JackkP/Semi-Truck-Backup-Camera/RPICAM_Adapter_PCB/KiCAD/References/Lichee Pi Zero Camera Pins.png

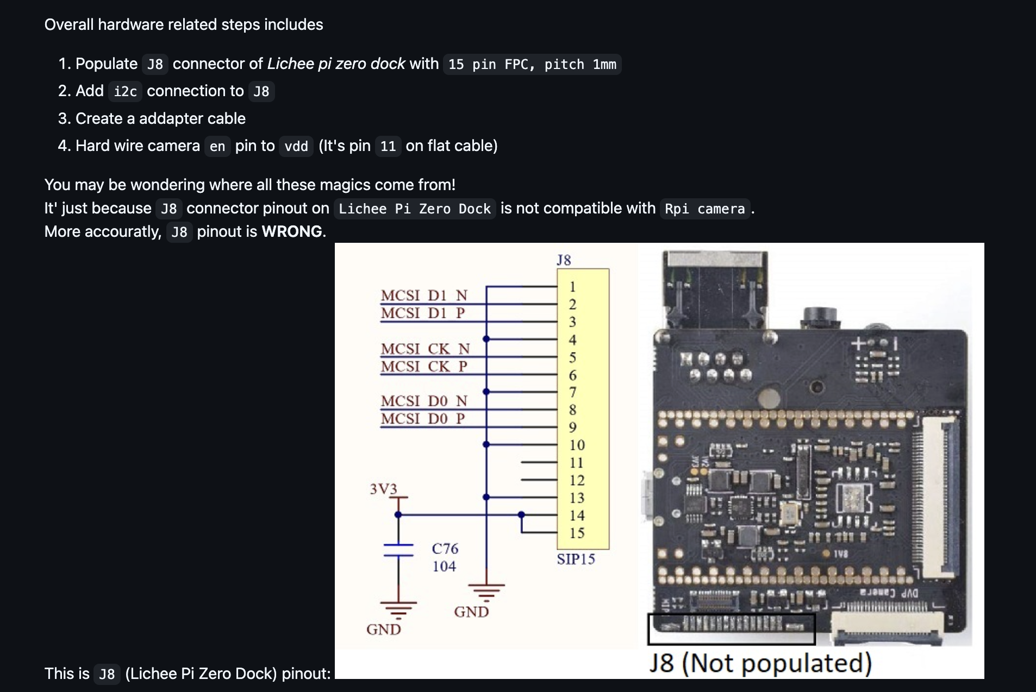
RPICAM_Adapter_PCB/KiCAD/References/Lichee Pi Zero Camera Pins.png
