JackkP/Semi-Truck-Backup-Camera/RPICAM_Adapter_PCB/KiCAD/References/Lichee Pi Zero Pin Mapping.png

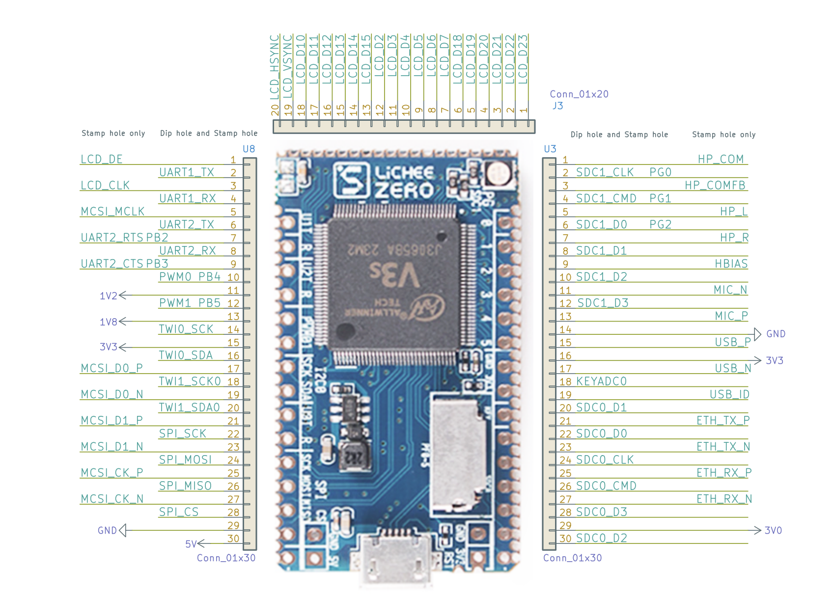
RPICAM_Adapter_PCB/KiCAD/References/Lichee Pi Zero Pin Mapping.png
