JackkP/Semi-Truck-Backup-Camera/README.md

# Semi-Truck-Backup-Camera
Repository for Team 25 Purdue ECE Senior Design Fall 2025 49022 Senior Design Project. This contains all of the code and schematics for the project. Course-related documentation is stored in google.
