JackkP/Semi-Truck-Backup-Camera/RPICAM_Adapter_PCB/KiCAD/References/RPI Camera Pinout.png

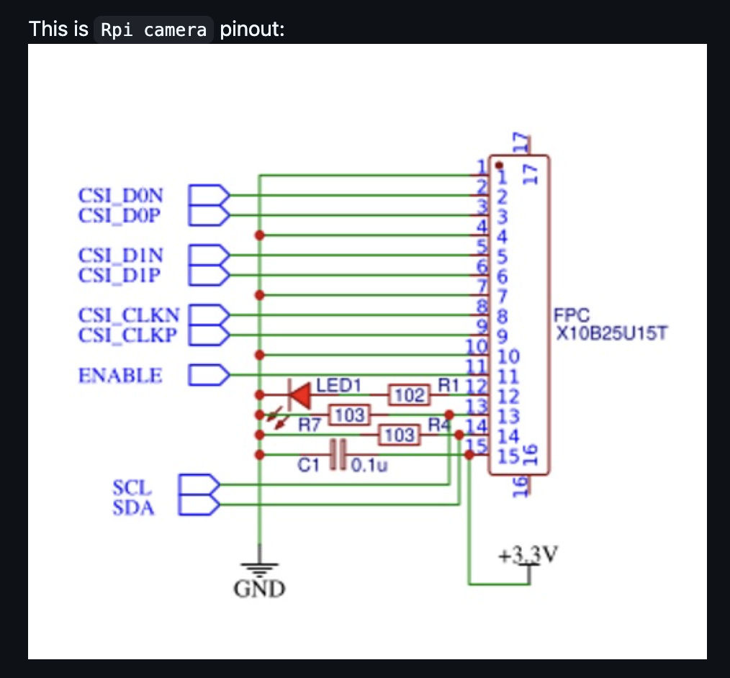
RPICAM_Adapter_PCB/KiCAD/References/RPI Camera Pinout.png
