JackkP/Semi-Truck-Backup-Camera/Camera_PCB/3D models/ECS-240-12-36-AGN-TR.step

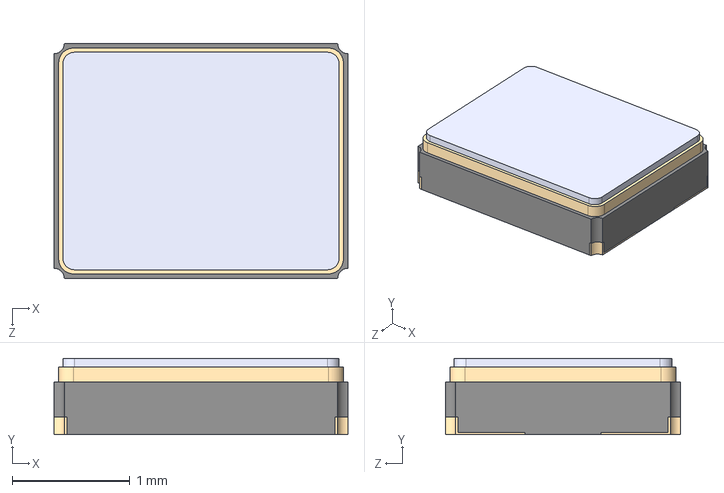
[picture p4: CAD file, 2025-11-12]
Camera_PCB/3D models/ECS-240-12-36-AGN-TR.step
2.50 x 0.65 x 2.00 mm
