JackkP/Semi-Truck-Backup-Camera/Camera_PCB/3D models/QFN48_P040_H085.stp

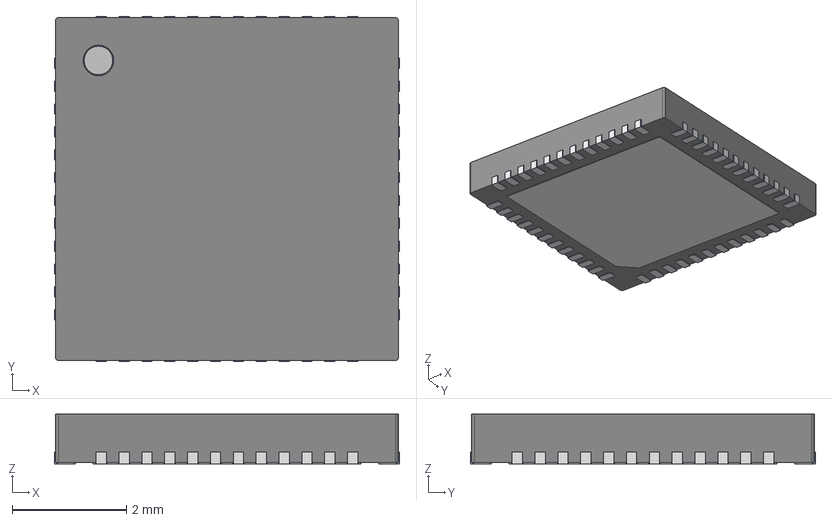
[picture p5: CAD file, 2025-11-12]
Camera_PCB/3D models/QFN48_P040_H085.stp
6.04 x 6.04 x 0.87 mm
QFN48P040_body
QFN48P040_pad
QFN48P040_pin x 48
