JackkP/Semi-Truck-Backup-Camera/Camera_PCB/3D models/B2B-PH-SM4-TB.step

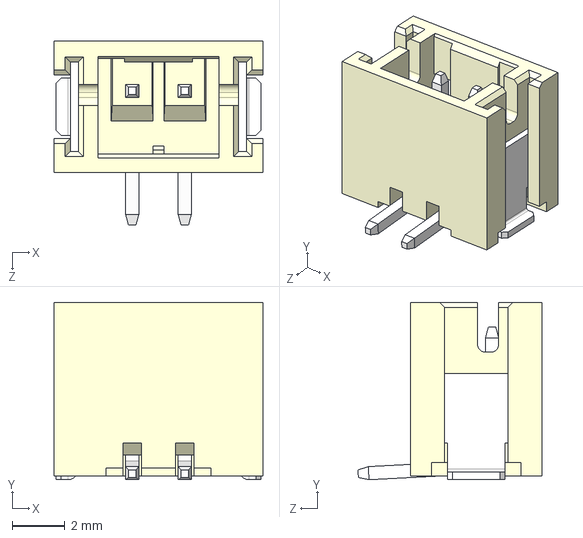
[picture p6: CAD file, 2025-11-12]
Camera_PCB/3D models/B2B-PH-SM4-TB.step
7.95 x 6.75 x 7.00 mm
