JackkP/Semi-Truck-Backup-Camera/Camera_PCB/3D models/ECS-.327-12.5-38-TR.STEP

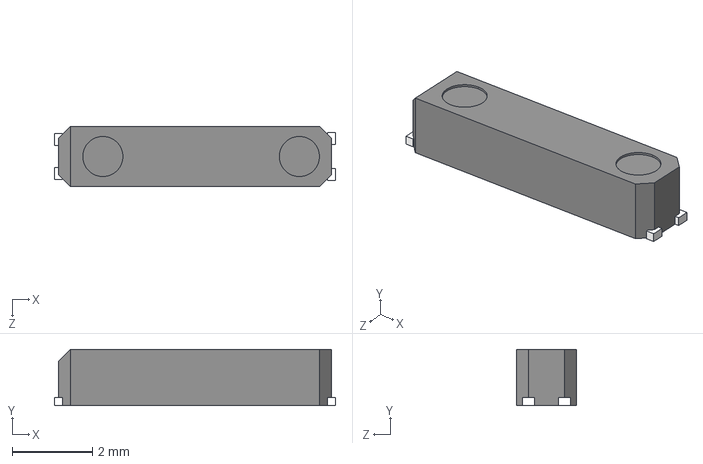
[picture p7: CAD file, 2025-11-12]
Camera_PCB/3D models/ECS-.327-12.5-38-TR.STEP
7.00 x 1.40 x 1.50 mm
