JackkP/Semi-Truck-Backup-Camera/Camera_PCB/3D models/USB1046-GF-0190-L-B-A.STEP

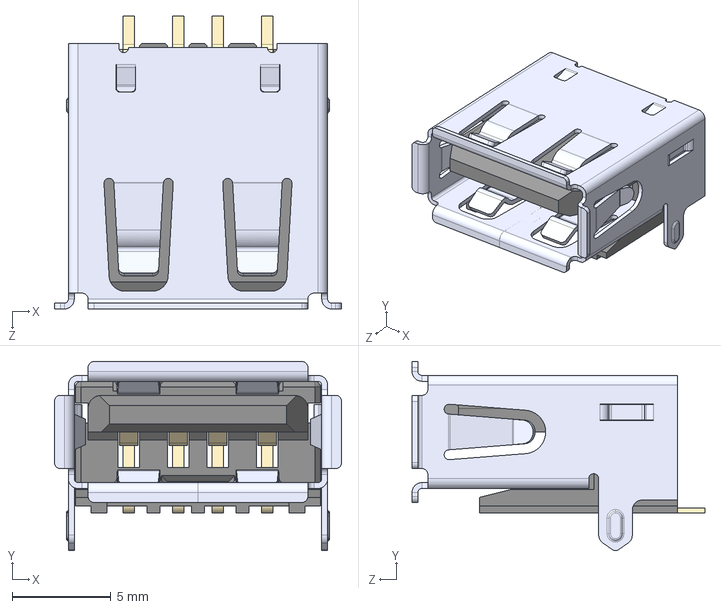
[picture p8: CAD file, 2025-11-12]
Camera_PCB/3D models/USB1046-GF-0190-L-B-A.STEP
14.5 x 9.55 x 14.8 mm
