JackkP/Semi-Truck-Backup-Camera/Camera_PCB/3D models/DFE201610E-1R0M=P2.STEP

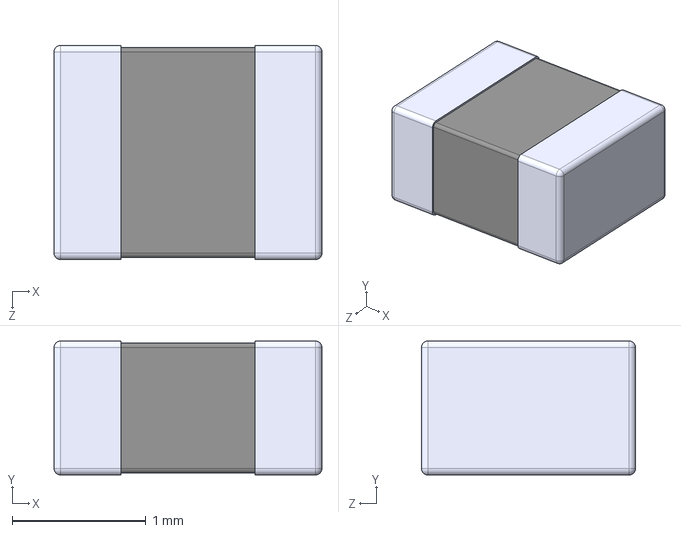
[picture p9: CAD file, 2025-11-12]
Camera_PCB/3D models/DFE201610E-1R0M=P2.STEP
2.00 x 1.00 x 1.60 mm
