JackkP/Semi-Truck-Backup-Camera/Camera_PCB/3D models/10067099-200LF.STEP

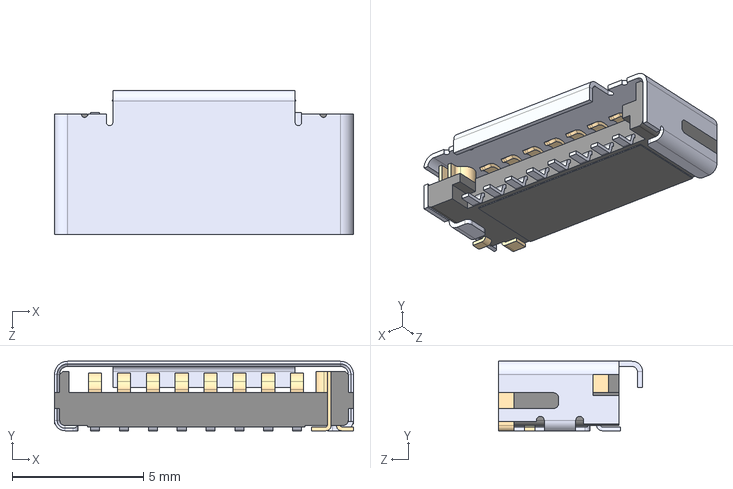
[picture p10: CAD file, 2025-11-12]
Camera_PCB/3D models/10067099-200LF.STEP
11.4 x 2.65 x 5.50 mm
