JackkP/Semi-Truck-Backup-Camera/Camera_PCB/3D models/TPS63020DSJT.step

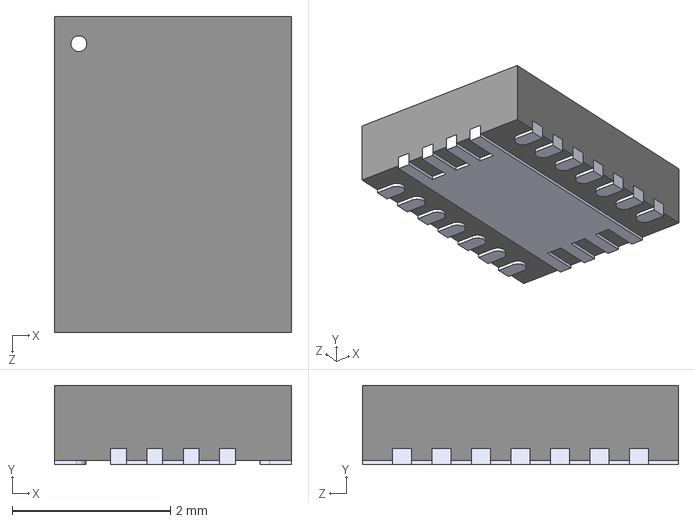
[picture p11: CAD file, 2025-11-12]
Camera_PCB/3D models/TPS63020DSJT.step
3.00 x 1.00 x 4.00 mm
