JackkP/Semi-Truck-Backup-Camera/Camera_PCB/CameraPCB.kicad_pcb

## KiCad design Camera_PCB/CameraPCB.kicad_pcb (2025-11-12)

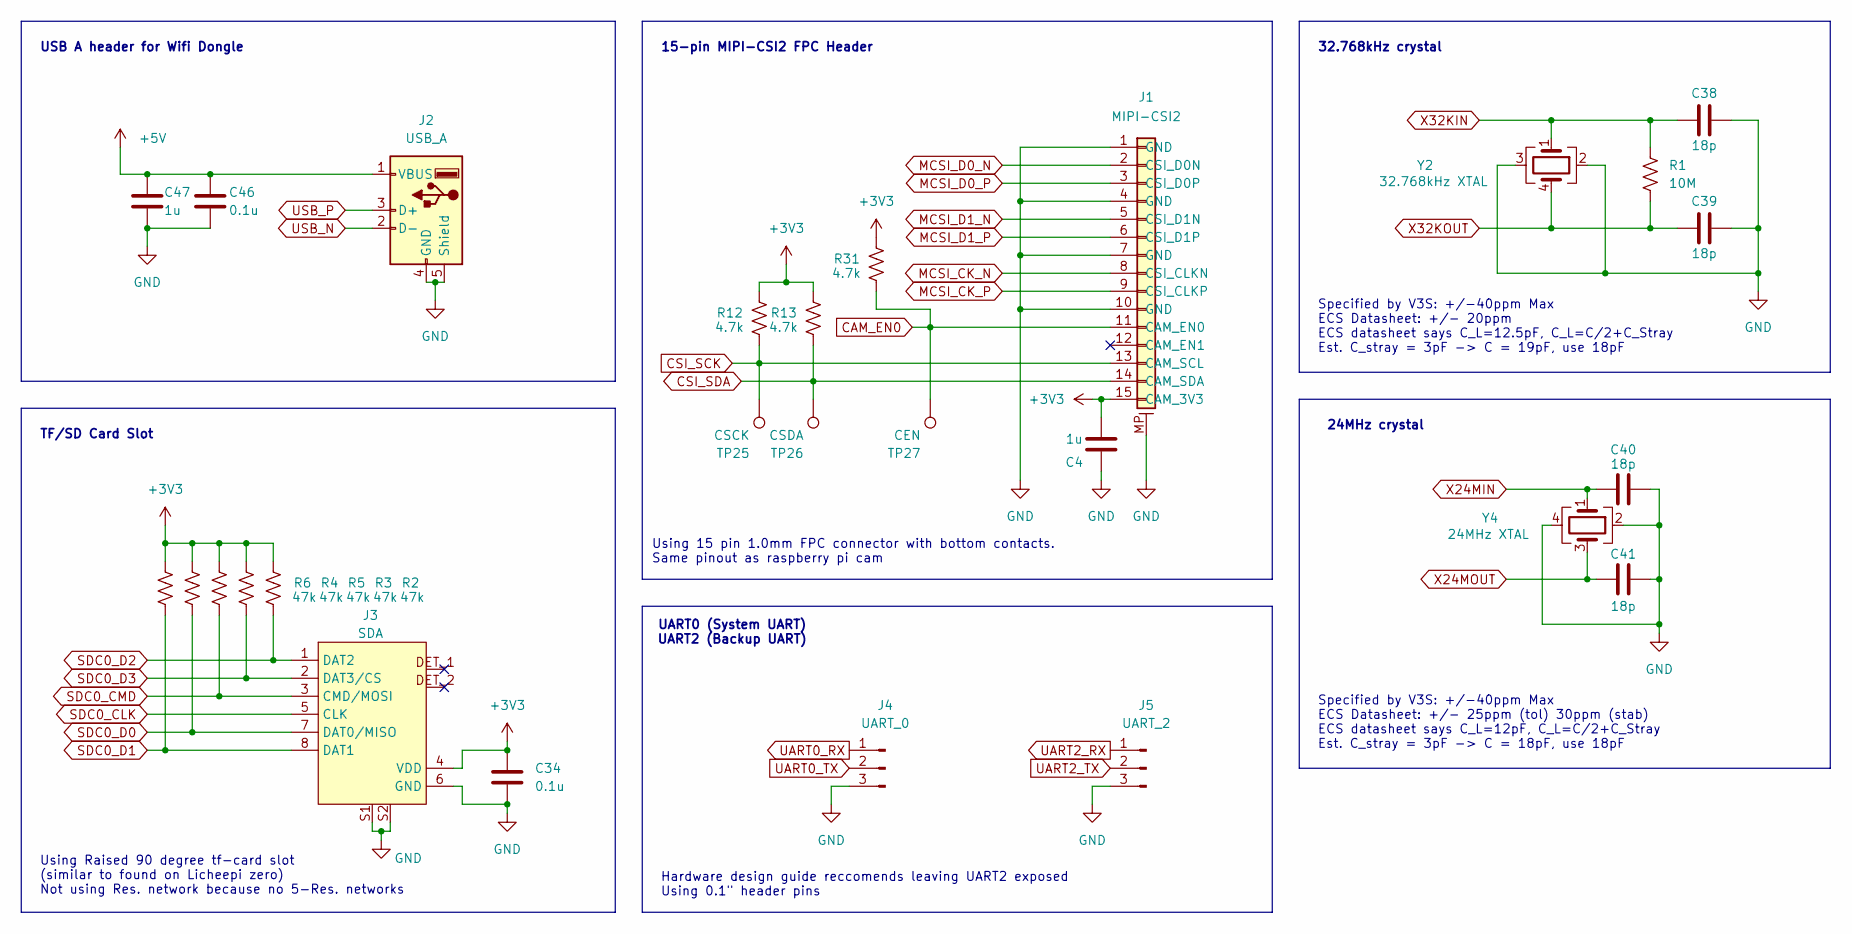
[picture p12: schematic CSI_USB_SD_OSC.kicad_sch, Wireless Backup Camera - Encoder]

Parts:
C4, C47: 1u; C_0603_1608Metric_Pad1.08x0.95mm_HandSolder
C34, C46: 0.1u; C_0603_1608Metric_Pad1.08x0.95mm_HandSolder
C38, C39, C40, C41: 18p; C_0603_1608Metric_Pad1.08x0.95mm_HandSolder
J1: MIPI-CSI2; TE_1-84952-5_1x15-1MP_P1.0mm_Horizontal
J2: USB_A; USB_A_Receptacle_GCT_USB1046
J3: SDA; AMPHENOL_10067099-200LF
J4: UART_0; PinHeader_1x03_P2.54mm_Vertical
J5: UART_2; PinHeader_1x03_P2.54mm_Vertical
R1: 10M; R_0603_1608Metric_Pad0.98x0.95mm_HandSolder
R2, R3, R4, R5, R6: 47k; R_0603_1608Metric_Pad0.98x0.95mm_HandSolder
R12, R13, R31: 4.7k; R_0603_1608Metric_Pad0.98x0.95mm_HandSolder
TP25: CSCK; TestPoint_Pad_D1.5mm
TP26: CSDA; TestPoint_Pad_D1.5mm
TP27: CEN; TestPoint_Pad_D1.5mm
Y2: 32.768kHz XTAL; XTAL_ECS-.327-12.5-38-TR
Y4: 24MHz XTAL; XTAL_ECS-240-12-36-AGN-TR

Connections:
+5V: C46.1, C47.1, J2.1 (VBUS); also elsewhere on the board
CAM_EN0: J1.11 (CAM_EN0), R31.2, TP27.1; also elsewhere on the board
CSI_SCK: J1.13 (CAM_SCL), R12.2, TP25.1; also elsewhere on the board
CSI_SDA: J1.14 (CAM_SDA), R13.2, TP26.1; also elsewhere on the board
GND: C4.2, C34.2, C38.2, C39.2, C40.2, C41.1, C46.2, C47.2, J1.1 (GND), J1.4 (GND), J1.7 (GND), J1.10 (GND), J1.MP, J2.4 (GND), J2.5 (Shield), J3.6 (GND), J3.S1, J3.S2, J4.3, J5.3, Y2.2, Y2.3, Y4.2, Y4.4; also elsewhere on the board
HPVCC: C4.1, C34.1, J1.15 (CAM_3V3), J3.4 (VDD), R2.1, R3.1, R4.1, R5.1, R6.1, R12.1, R13.1, R31.1; also elsewhere on the board
MCSI_CK_N: J1.8 (CSI_CLKN); also elsewhere on the board
MCSI_CK_P: J1.9 (CSI_CLKP); also elsewhere on the board
MCSI_D0_N: J1.2 (CSI_D0N); also elsewhere on the board
MCSI_D0_P: J1.3 (CSI_D0P); also elsewhere on the board
MCSI_D1_N: J1.5 (CSI_D1N); also elsewhere on the board
MCSI_D1_P: J1.6 (CSI_D1P); also elsewhere on the board
SDC0_CLK: J3.5 (CLK); also elsewhere on the board
SDC0_CMD: J3.3 (CMD/MOSI), R5.2; also elsewhere on the board
SDC0_D0: J3.7 (DAT0/MISO), R4.2; also elsewhere on the board
SDC0_D1: J3.8 (DAT1), R6.2; also elsewhere on the board
SDC0_D2: J3.1 (DAT2), R2.2; also elsewhere on the board
SDC0_D3: J3.2 (DAT3/CS), R3.2; also elsewhere on the board
UART0_RX: J4.1; also elsewhere on the board
UART0_TX: J4.2; also elsewhere on the board
UART2_RX: J5.1; also elsewhere on the board
UART2_TX: J5.2; also elsewhere on the board
USB_N: J2.2 (D-); also elsewhere on the board
USB_P: J2.3 (D+); also elsewhere on the board
X24MIN: C40.1, Y4.1; also elsewhere on the board
X24MOUT: C41.2, Y4.3; also elsewhere on the board
X32KIN: C38.1, R1.1, Y2.1; also elsewhere on the board
X32KOUT: C39.1, R1.2, Y2.4; also elsewhere on the board

Notes on the sheet:
TF/SD Card Slot
Hardware design guide reccomends leaving UART2 exposed Using 0.1" header pins
15-pin MIPI-CSI2 FPC Header
UART0 (System UART) UART2 (Backup UART)
Specified by V3S: +/-40ppm Max ECS Datasheet: +/- 25ppm (tol) 30ppm (stab) ECS datasheet says C_L=12pF, C_L=C/2+C_Stray Est. C_stray = 3pF -> C = 18pF, use 18pF
Specified by V3S: +/-40ppm Max ECS Datasheet: +/- 20ppm ECS datasheet says C_L=12.5pF, C_L=C/2+C_Stray Est. C_stray = 3pF -> C = 19pF, use 18pF
32.768kHz crystal
Using 15 pin 1.0mm FPC connector with bottom contacts. Same pinout as raspberry pi cam
24MHz crystal
USB A header for Wifi Dongle
Using Raised 90 degree tf-card slot (similar to found on Licheepi zero) Not using Res. network because no 5-Res. networks

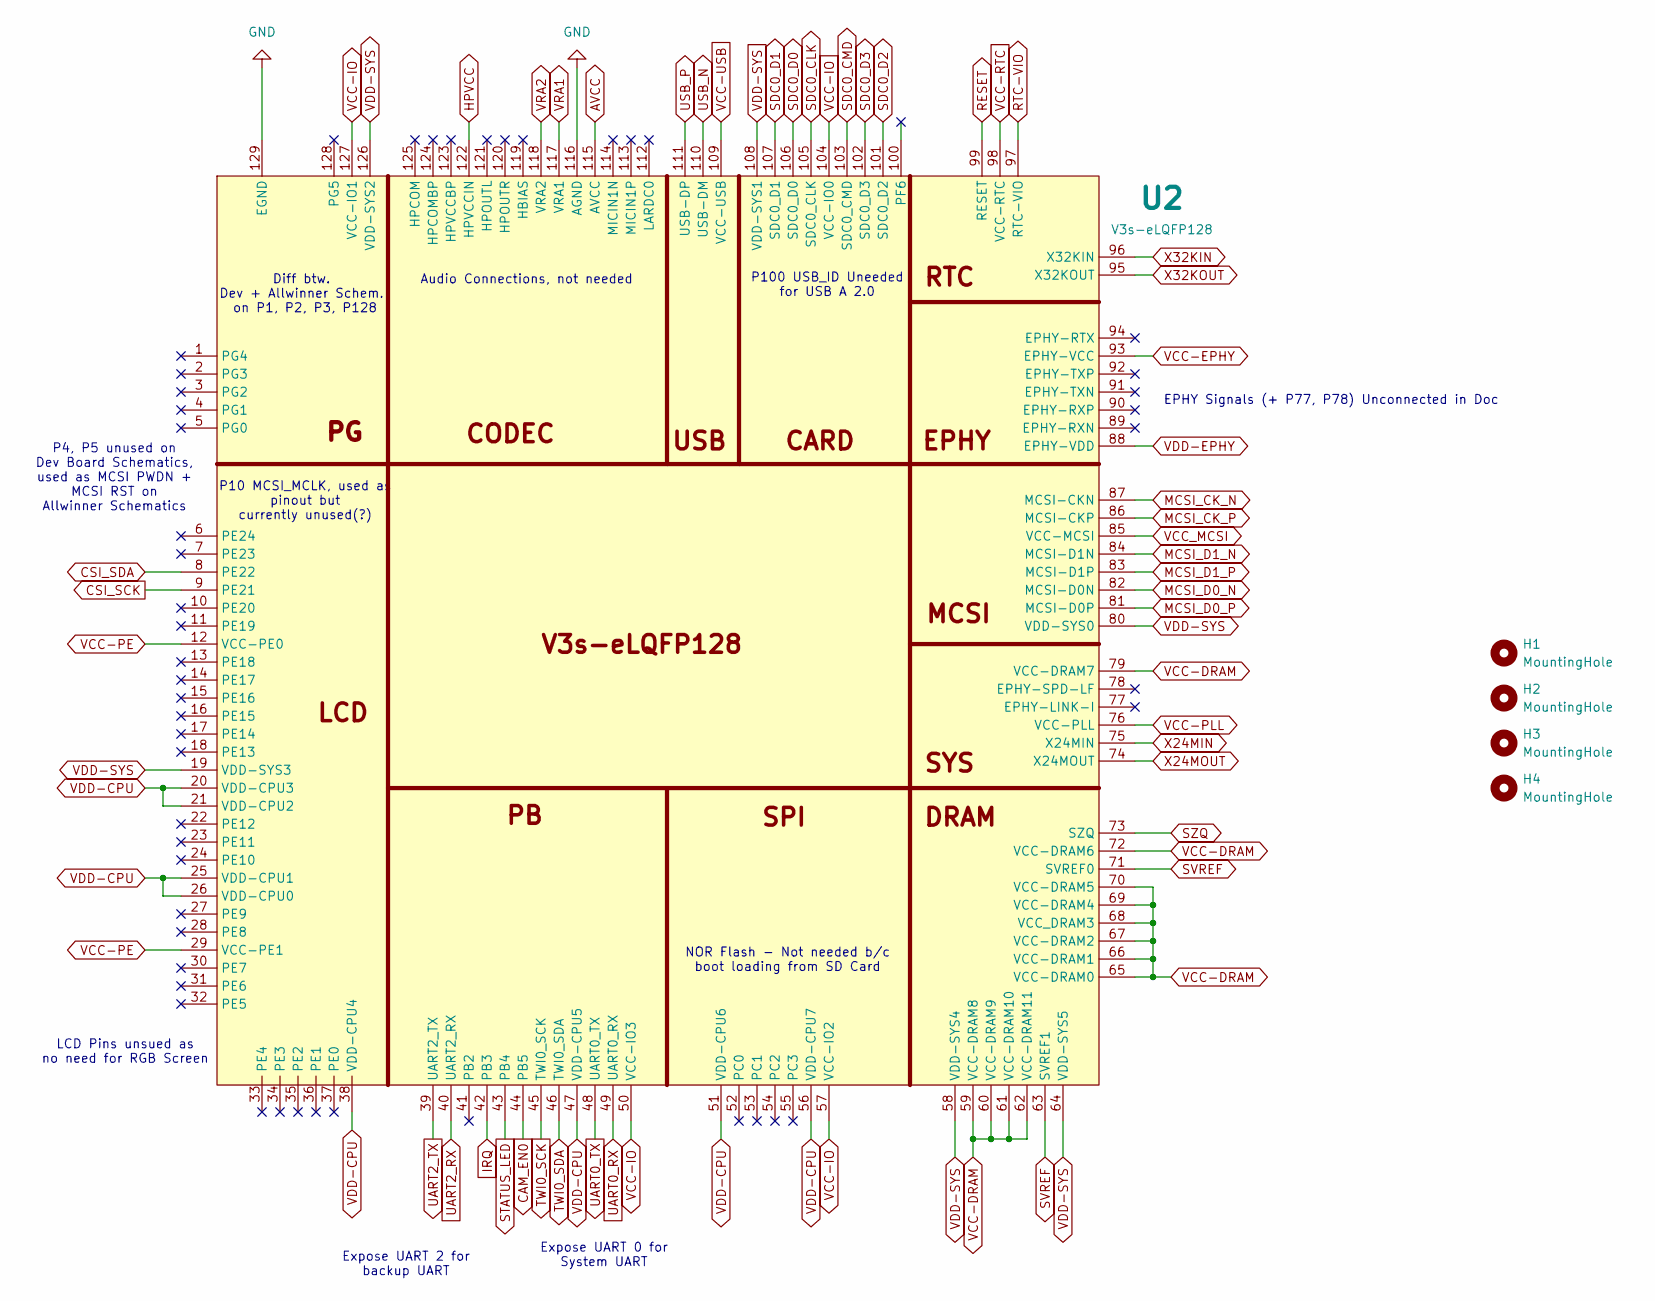
[picture p13: schematic V3s.kicad_sch]

Parts:
H1, H2, H3, H4: MountingHole; MountingHole_2.2mm_M2
U2: V3s-eLQFP128; LQFP-128_14x14mm_P0.4mm

Connections:
AVCC: U2.76 (VCC-PLL), U2.115 (AVCC); also elsewhere on the board
CAM_EN0: U2.44 (PB5); also elsewhere on the board
CSI_SCK: U2.9 (PE21); also elsewhere on the board
CSI_SDA: U2.8 (PE22); also elsewhere on the board
GND: U2.116 (AGND), U2.129 (EGND); also elsewhere on the board
HPVCC: U2.12 (VCC-PE0), U2.29 (VCC-PE1), U2.50 (VCC-IO3), U2.57 (VCC-IO2), U2.85 (VCC-MCSI), U2.93 (EPHY-VCC), U2.104 (VCC-IO0), U2.109 (VCC-USB), U2.122 (HPVCCIN), U2.127 (VCC-IO1); also elsewhere on the board
IRQ: U2.42 (PB3); also elsewhere on the board
MCSI_CK_N: U2.87 (MCSI-CKN); also elsewhere on the board
MCSI_CK_P: U2.86 (MCSI-CKP); also elsewhere on the board
MCSI_D0_N: U2.82 (MCSI-D0N); also elsewhere on the board
MCSI_D0_P: U2.81 (MCSI-D0P); also elsewhere on the board
MCSI_D1_N: U2.84 (MCSI-D1N); also elsewhere on the board
MCSI_D1_P: U2.83 (MCSI-D1P); also elsewhere on the board
RESET: U2.99 (RESET); also elsewhere on the board
RTC-VIO: U2.97 (RTC-VIO); also elsewhere on the board
SDC0_CLK: U2.105 (SDC0_CLK); also elsewhere on the board
SDC0_CMD: U2.103 (SDC0_CMD); also elsewhere on the board
SDC0_D0: U2.106 (SDC0_D0); also elsewhere on the board
SDC0_D1: U2.107 (SDC0_D1); also elsewhere on the board
SDC0_D2: U2.101 (SDC0_D2); also elsewhere on the board
SDC0_D3: U2.102 (SDC0_D3); also elsewhere on the board
STATUS_LED: U2.43 (PB4); also elsewhere on the board
SVREF: U2.63 (SVREF1), U2.71 (SVREF0); also elsewhere on the board
SZQ: U2.73 (SZQ); also elsewhere on the board
TWI0_SCK: U2.45 (TWI0_SCK); also elsewhere on the board
TWI0_SDA: U2.46 (TWI0_SDA); also elsewhere on the board
UART0_RX: U2.49 (UART0_RX); also elsewhere on the board
UART0_TX: U2.48 (UART0_TX); also elsewhere on the board
UART2_RX: U2.40 (UART2_RX); also elsewhere on the board
UART2_TX: U2.39 (UART2_TX); also elsewhere on the board
USB_N: U2.110 (USB-DM); also elsewhere on the board
USB_P: U2.111 (USB-DP); also elsewhere on the board
VCC-DRAM: U2.59 (VCC-DRAM8), U2.60 (VCC-DRAM9), U2.61 (VCC-DRAM10), U2.62 (VCC-DRAM11), U2.65 (VCC-DRAM0), U2.66 (VCC-DRAM1), U2.67 (VCC-DRAM2), U2.68 (VCC_DRAM3), U2.69 (VCC-DRAM4), U2.70 (VCC-DRAM5), U2.72 (VCC-DRAM6), U2.79 (VCC-DRAM7); also elsewhere on the board
VCC-RTC: U2.98 (VCC-RTC); also elsewhere on the board
VDD-CPU: U2.19 (VDD-SYS3), U2.20 (VDD-CPU3), U2.21 (VDD-CPU2), U2.25 (VDD-CPU1), U2.26 (VDD-CPU0), U2.38 (VDD-CPU4), U2.47 (VDD-CPU5), U2.51 (VDD-CPU6), U2.56 (VDD-CPU7), U2.58 (VDD-SYS4), U2.64 (VDD-SYS5), U2.80 (VDD-SYS0), U2.88 (EPHY-VDD), U2.108 (VDD-SYS1), U2.126 (VDD-SYS2); also elsewhere on the board
VRA1: U2.117 (VRA1); also elsewhere on the board
VRA2: U2.118 (VRA2); also elsewhere on the board
X24MIN: U2.75 (X24MIN); also elsewhere on the board
X24MOUT: U2.74 (X24MOUT); also elsewhere on the board
X32KIN: U2.96 (X32KIN); also elsewhere on the board
X32KOUT: U2.95 (X32KOUT); also elsewhere on the board

Notes on the sheet:
P10 MCSI_MCLK, used as pinout but currently unused(?)
EPHY Signals (+ P77, P78) Unconnected in Doc
Audio Connections, not needed
NOR Flash - Not needed b/c boot loading from SD Card
P4, P5 unused on Dev Board Schematics, used as MCSI PWDN + MCSI RST on Allwinner Schematics
P100 USB_ID Uneeded for USB A 2.0
Expose UART 2 for backup UART
LCD Pins unsued as no need for RGB Screen
Expose UART 0 for System UART
Diff btw. Dev + Allwinner Schem. on P1, P2, P3, P128

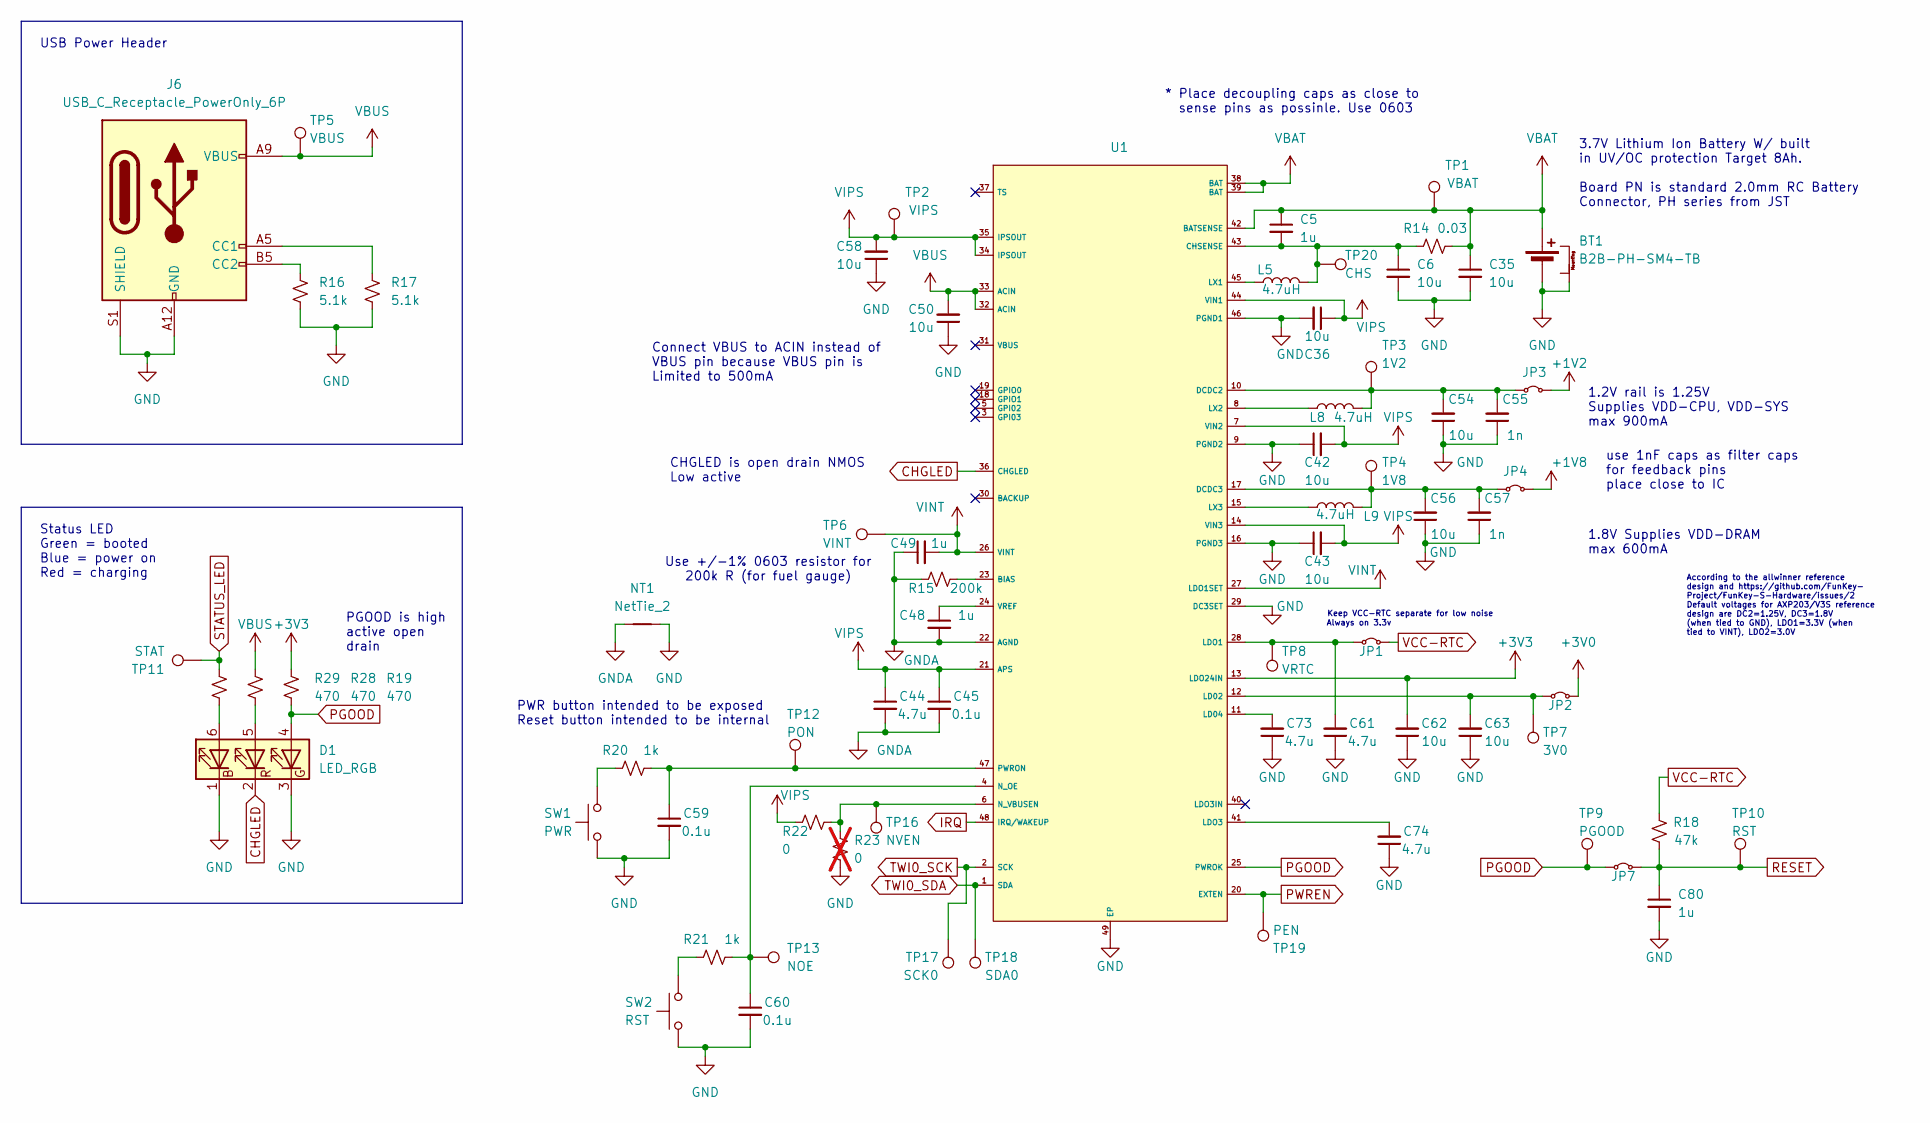
[picture p14: schematic AXP203.kicad_sch]

Parts:
BT1: B2B-PH-SM4-TB; JST_PH_B2B-PH-SM4-TB_1x02-1MP_P2.00mm_Vertical
C5, C48, C49, C80: 1u; C_0603_1608Metric_Pad1.08x0.95mm_HandSolder
C6, C35, C36, C42, C43, C50, C54, C56, C58, C62, C63: 10u; C_0805_2012Metric_Pad1.18x1.45mm_HandSolder
C44, C61, C73, C74: 4.7u; C_0805_2012Metric_Pad1.18x1.45mm_HandSolder
C45, C59, C60: 0.1u; C_0603_1608Metric_Pad1.08x0.95mm_HandSolder
C55, C57: 1n; C_0603_1608Metric_Pad1.08x0.95mm_HandSolder
D1: LED_RGB; RGB_LED IN-S66TFT5R5G5B
J6: USB_C_Receptacle_PowerOnly_6P; USB_C_Receptacle_GCT_USB4125-xx-x_6P_TopMnt_Horizontal
JP1, JP2, JP3, JP4, JP7: SolderJumper-2_P1.3mm_Open_Pad1.0x1.5mm
L5, L8, L9: 4.7uH; L_TDK_SLF6045
NT1: NetTie_2; NetTie-2_SMD_Pad0.5mm
R14: 0.03; R_1206_3216Metric
R15: 200k; R_0603_1608Metric_Pad0.98x0.95mm_HandSolder
R16, R17: 5.1k; R_0603_1608Metric_Pad0.98x0.95mm_HandSolder
R18: 47k; R_0603_1608Metric_Pad0.98x0.95mm_HandSolder
R19, R28, R29: 470; R_0603_1608Metric_Pad0.98x0.95mm_HandSolder
R20, R21: 1k; R_0603_1608Metric_Pad0.98x0.95mm_HandSolder
R22: 0; R_0603_1608Metric_Pad0.98x0.95mm_HandSolder
R23: 0; R_0603_1608Metric_Pad0.98x0.95mm_HandSolder; not fitted
SW1: PWR; SW_SPST_PTS647_Sx38
SW2: RST; SW_SPST_PTS647_Sx38
TP1: VBAT; TestPoint_Pad_D1.5mm
TP2: VIPS; TestPoint_Pad_D1.5mm
TP3: 1V2; TestPoint_Pad_D1.5mm
TP4: 1V8; TestPoint_Pad_D1.5mm
TP5: VBUS; TestPoint_Pad_D1.5mm
TP6: VINT; TestPoint_Pad_D1.5mm
TP7: 3V0; TestPoint_Pad_D1.5mm
TP8: VRTC; TestPoint_Pad_D1.5mm
TP9: PGOOD; TestPoint_Pad_D1.5mm
TP10: RST; TestPoint_Pad_D1.5mm
TP11: STAT; TestPoint_Pad_D1.5mm
TP12: PON; TestPoint_Pad_D1.5mm
TP13: NOE; TestPoint_Pad_D1.5mm
TP16: NVEN; TestPoint_Pad_D1.5mm
TP17: SCK0; TestPoint_Pad_D1.5mm
TP18: SDA0; TestPoint_Pad_D1.5mm
TP19: PEN; TestPoint_Pad_D1.5mm
TP20: CHS; TestPoint_Pad_D1.5mm
U1: AXP203; QFN-48-1EP_6x6mm_P0.4mm_EP4.2x4.2mm

Connections:
AVCC: JP2.2 (B); also elsewhere on the board
CHGLED: D1.2 (GK), U1.36 (CHGLED)
GND: BT1.2 (-), BT1.MP, C6.2, C35.2, C36.2, C42.1, C43.1, C50.1, C54.1, C55.1, C56.1, C57.1, C58.1, C59.2, C60.2, C61.1, C62.1, C63.1, C73.1, C74.1, C80.2, D1.1 (RK), D1.3 (BK), J6.A12 (GND), J6.B12 (GND), J6.S1 (SHIELD), NT1.2, R16.2, R17.2, R23.1, SW1.1, SW2.1, U1.9 (PGND2), U1.16 (PGND3), U1.29 (DC3SET), U1.46 (PGND1), U1.49 (EP); also elsewhere on the board
GNDA: C44.2, C45.2, C48.2, C49.1, NT1.1, R15.1, U1.22 (AGND)
HPVCC: C62.2, R19.1, U1.13 (LDO24IN); also elsewhere on the board
IRQ: U1.48 (IRQ/WAKEUP); also elsewhere on the board
unnamed: D1.5 (GA), R28.2
unnamed: D1.6 (RA), R29.2
unnamed: J6.A5 (CC1), R17.1
unnamed: J6.B5 (CC2), R16.1
unnamed: C61.2, JP1.1 (A), TP8.1, U1.28 (LDO1)
unnamed: C63.2, JP2.1 (A), TP7.1, U1.12 (LD02)
unnamed: C54.2, C55.2, JP3.1 (A), L8.2, TP3.1, U1.10 (DCDC2)
unnamed: C56.2, C57.2, JP4.1 (A), L9.2, TP4.1, U1.17 (DCDC3)
unnamed: R20.1, SW1.2
unnamed: R21.1, SW2.2
unnamed: R15.2, U1.23 (BIAS)
unnamed: C5.2, C6.1, L5.2, R14.1, TP20.1, U1.43 (CHSENSE)
unnamed: C73.2, U1.11 (LD04)
unnamed: C74.2, U1.41 (LDO3)
unnamed: L5.1, U1.45 (LX1)
unnamed: L8.1, U1.8 (LX2)
unnamed: L9.1, U1.15 (LX3)
unnamed: C60.1, R21.2, TP13.1, U1.4 (N_OE)
unnamed: R22.2, R23.2, TP16.1, U1.6 (N_VBUSEN)
unnamed: C59.1, R20.2, TP12.1, U1.47 (PWRON)
unnamed: C48.1, U1.24 (VREF)
PGOOD: D1.4 (BA), JP7.1 (A), R19.2, TP9.1, U1.25 (PWROK); also elsewhere on the board
PWREN: TP19.1, U1.20 (EXTEN); also elsewhere on the board
RESET: C80.1, JP7.2 (B), R18.2, TP10.1; also elsewhere on the board
STATUS_LED: R29.1, TP11.1; also elsewhere on the board
TWI0_SCK: TP17.1, U1.2 (SCK); also elsewhere on the board
TWI0_SDA: TP18.1, U1.1 (SDA); also elsewhere on the board
VBAT: BT1.1 (+), C5.1, C35.1, R14.2, TP1.1, U1.38 (BAT), U1.39 (BAT), U1.42 (BATSENSE); also elsewhere on the board
VBUS: C50.2, J6.A9 (VBUS), J6.B9 (VBUS), R28.1, TP5.1, U1.32 (ACIN), U1.33 (ACIN)
VCC-DRAM: JP4.2 (B); also elsewhere on the board
VCC-RTC: JP1.2 (B), R18.1; also elsewhere on the board
VDD-CPU: JP3.2 (B); also elsewhere on the board
VINT: C49.2, TP6.1, U1.26 (VINT), U1.27 (LDO1SET)
VIPS: C36.1, C42.2, C43.2, C44.1, C45.1, C58.2, R22.1, TP2.1, U1.7 (VIN2), U1.14 (VIN3), U1.21 (APS), U1.34 (IPSOUT), U1.35 (IPSOUT), U1.44 (VIN1); also elsewhere on the board

Notes on the sheet:
1.2V rail is 1.25V Supplies VDD-CPU, VDD-SYS max 900mA
PWR button intended to be exposed Reset button intended to be internal
PGOOD is high active open drain
Connect VBUS to ACIN instead of VBUS pin because VBUS pin is Limited to 500mA
USB Power Header
CHGLED is open drain NMOS Low active
use 1nF caps as filter caps for feedback pins place close to IC
According to the allwinner reference design and https://github.com/FunKey- Project/FunKey-S-Hardware/issues/2 Default voltages for AXP203/V3S reference design are DC2=1.25V, DC3=1.8V (when tied to GND), LDO1=3.3V (when tied to VINT), LDO2=3.0V
3.7V Lithium Ion Battery W/ built in UV/OC protection Target 8Ah. Board PN is standard 2.0mm RC Battery Connector, PH series from JST
Always on 3.3v
Keep VCC-RTC separate for low noise
Use +/-1% 0603 resistor for 200k R (for fuel gauge)
Status LED Green = booted Blue = power on Red = charging
* Place decoupling caps as close to sense pins as possinle. Use 0603
1.8V Supplies VDD-DRAM max 600mA

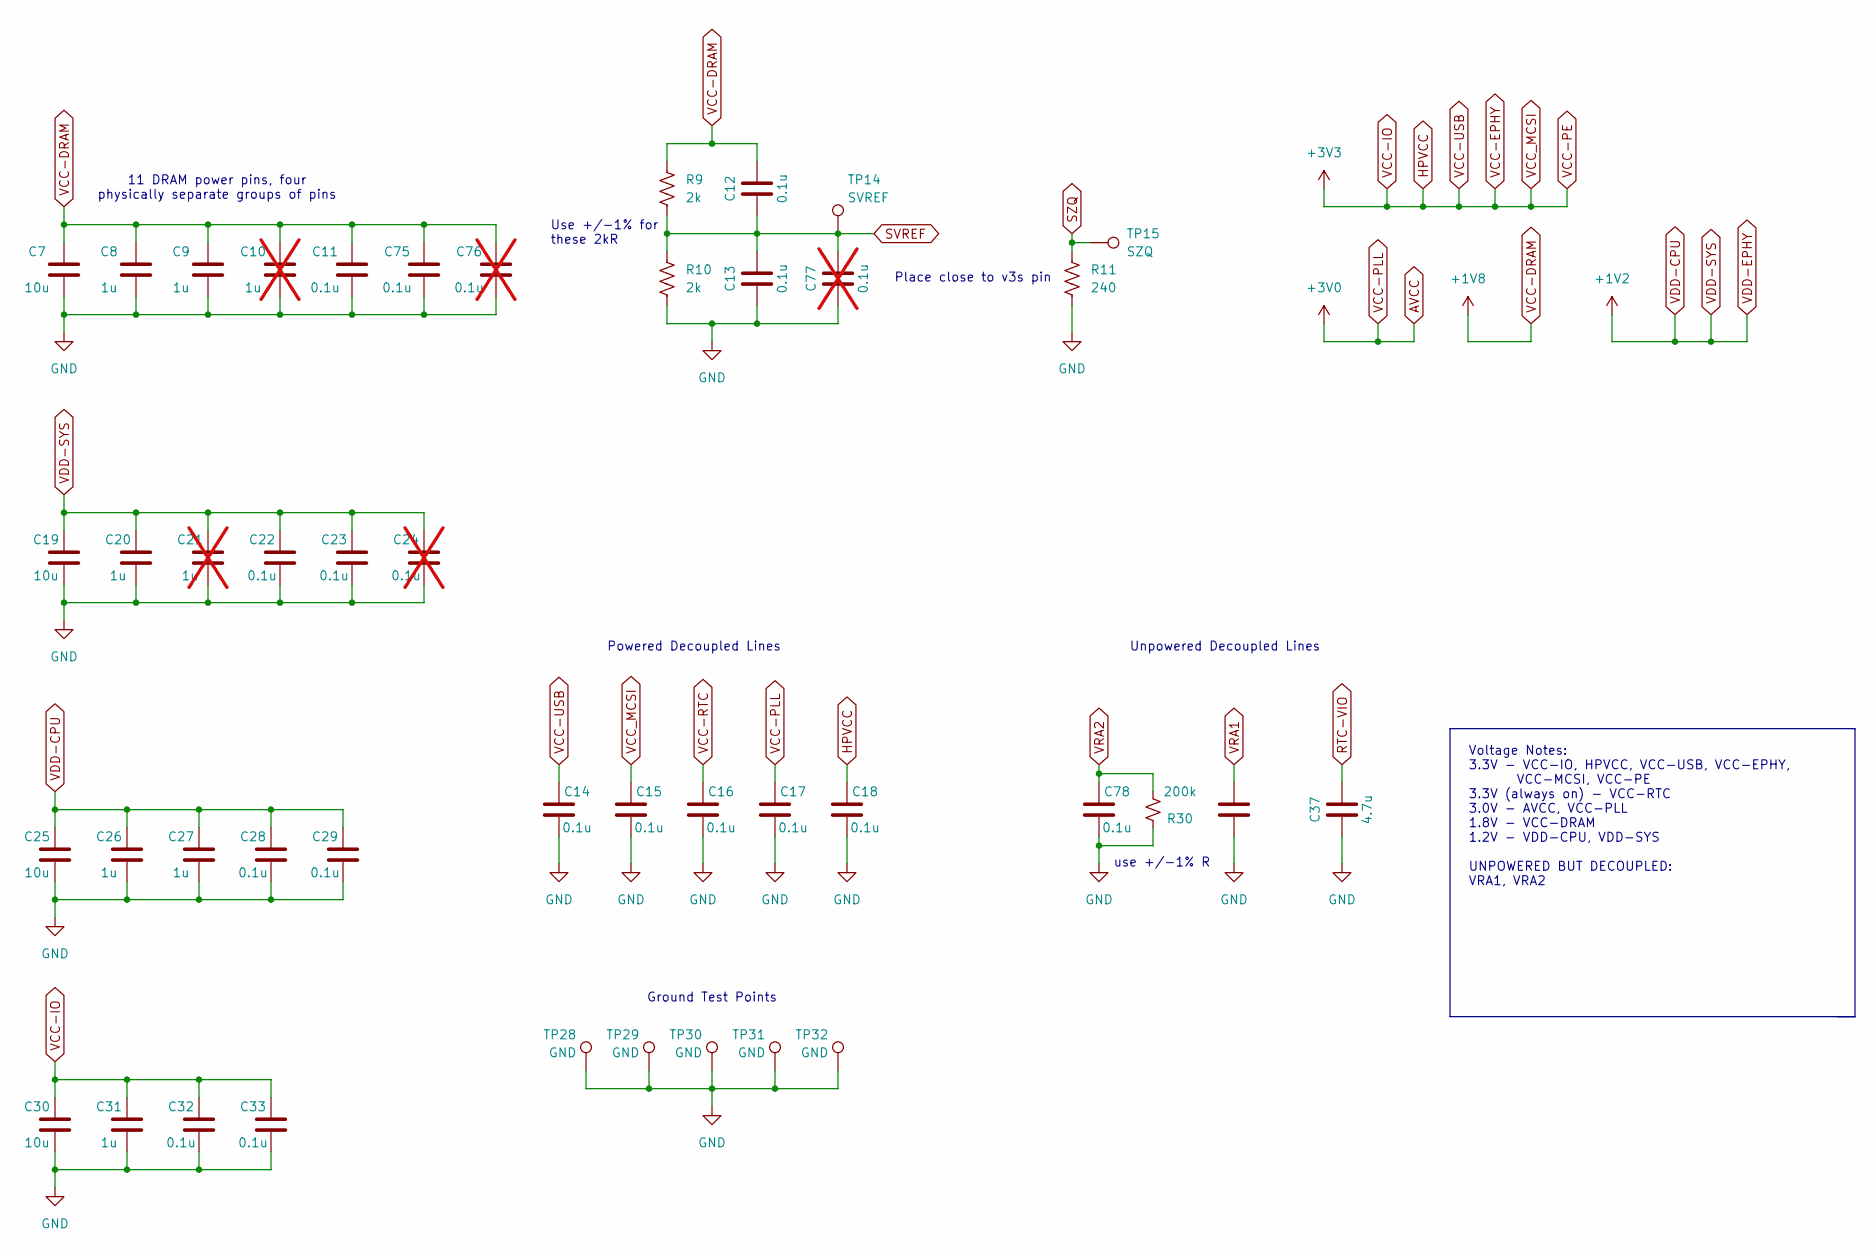
[picture p15: schematic DC_CAP_RAIL_TIES.kicad_sch, Wireless Backup Camera - Encoder]

Parts:
C7, C19, C25, C30: 10u; C_0805_2012Metric_Pad1.18x1.45mm_HandSolder
C8, C9, C20, C26, C27, C31: 1u; C_0603_1608Metric_Pad1.08x0.95mm_HandSolder
C10, C21: 1u; C_0603_1608Metric_Pad1.08x0.95mm_HandSolder; not fitted
C11, C12, C13, C14, C15, C16, C17, C18, C22, C23, C28, C29, C32, C33, C75, C78, C79: 0.1u; C_0603_1608Metric_Pad1.08x0.95mm_HandSolder
C24, C76, C77: 0.1u; C_0603_1608Metric_Pad1.08x0.95mm_HandSolder; not fitted
C37: 4.7u; C_0805_2012Metric_Pad1.18x1.45mm_HandSolder
R9, R10: 2k; R_0603_1608Metric_Pad0.98x0.95mm_HandSolder
R11: 240; R_0603_1608Metric_Pad0.98x0.95mm_HandSolder
R30: 200k; R_0603_1608Metric_Pad0.98x0.95mm_HandSolder
TP14: SVREF; TestPoint_Pad_D1.5mm
TP15: SZQ; TestPoint_Pad_D1.5mm
TP28, TP29, TP30, TP31, TP32: GND; TestPoint_Pad_D1.5mm

Connections:
AVCC: C17.2; also elsewhere on the board
GND: C7.1, C8.1, C9.1, C10.1, C11.1, C13.1, C14.1, C15.1, C16.1, C17.1, C18.1, C19.1, C20.1, C21.1, C22.1, C23.1, C24.1, C25.1, C26.1, C27.1, C28.1, C29.1, C30.1, C31.1, C32.1, C33.1, C37.1, C75.1, C76.1, C77.1, C78.1, C79.1, R10.2, R11.2, R30.1, TP28.1, TP29.1, TP30.1, TP31.1, TP32.1; also elsewhere on the board
HPVCC: C14.2, C15.2, C18.2, C30.2, C31.2, C32.2, C33.2; also elsewhere on the board
RTC-VIO: C37.2; also elsewhere on the board
SVREF: C12.1, C13.2, C77.2, R9.2, R10.1, TP14.1; also elsewhere on the board
SZQ: R11.1, TP15.1; also elsewhere on the board
VCC-DRAM: C7.2, C8.2, C9.2, C10.2, C11.2, C12.2, C75.2, C76.2, R9.1; also elsewhere on the board
VCC-RTC: C16.2; also elsewhere on the board
VDD-CPU: C19.2, C20.2, C21.2, C22.2, C23.2, C24.2, C25.2, C26.2, C27.2, C28.2, C29.2; also elsewhere on the board
VRA1: C79.2; also elsewhere on the board
VRA2: C78.2, R30.2; also elsewhere on the board

Notes on the sheet:
Place close to v3s pin
11 DRAM power pins, four physically separate groups of pins
Voltage Notes: 3.3V - VCC-IO, HPVCC, VCC-USB, VCC-EPHY, VCC-MCSI, VCC-PE 3.3V (always on) - VCC-RTC 3.0V - AVCC, VCC-PLL 1.8V - VCC-DRAM 1.2V - VDD-CPU, VDD-SYS UNPOWERED BUT DECOUPLED: VRA1, VRA2
Ground Test Points
Powered Decoupled Lines
Use +/-1% for these 2kR
Unpowered Decoupled Lines
use +/-1% R

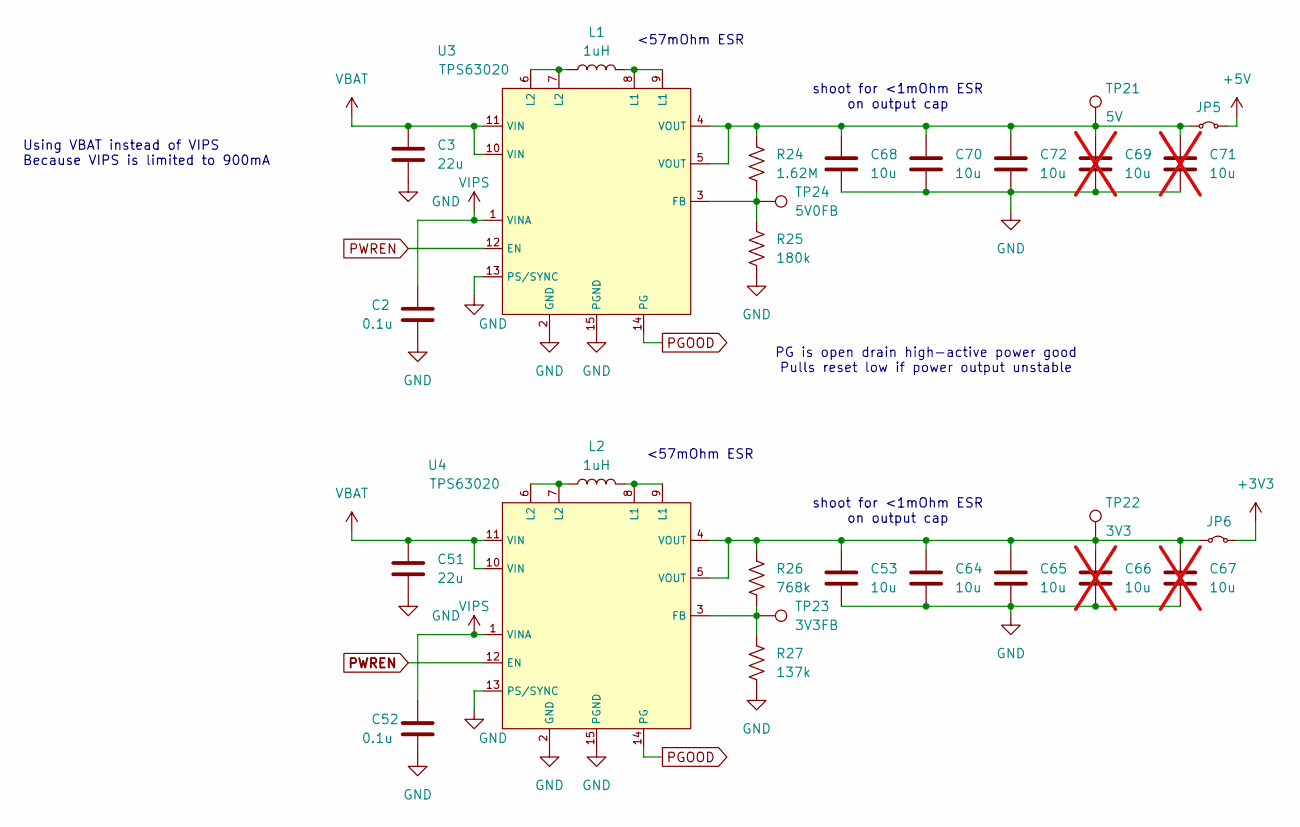
[picture p16: schematic 3V3_5V0.kicad_sch, Wireless Backup Camera - Encoder]

Parts:
C2, C52: 0.1u; C_0603_1608Metric_Pad1.08x0.95mm_HandSolder
C3, C51: 22u; C_0805_2012Metric_Pad1.18x1.45mm_HandSolder
C53, C64, C65, C68, C70, C72: 10u; C_0805_2012Metric_Pad1.18x1.45mm_HandSolder
C66, C67, C69, C71: 10u; C_0805_2012Metric_Pad1.18x1.45mm_HandSolder; not fitted
JP5, JP6: SolderJumper-2_P1.3mm_Open_Pad1.0x1.5mm
L1, L2: 1uH; L_Murata_DFE201610P
R24: 1.62M; R_0603_1608Metric_Pad0.98x0.95mm_HandSolder
R25: 180k; R_0603_1608Metric_Pad0.98x0.95mm_HandSolder
R26: 768k; R_0603_1608Metric_Pad0.98x0.95mm_HandSolder
R27: 137k; R_0603_1608Metric_Pad0.98x0.95mm_HandSolder
TP21: 5V; TestPoint_Pad_D1.5mm
TP22: 3V3; TestPoint_Pad_D1.5mm
TP23: 3V3FB; TestPoint_Pad_D1.5mm
TP24: 5V0FB; TestPoint_Pad_D1.5mm
U3, U4: TPS63020; IC_TPS63020DSJT

Connections:
+5V: JP5.2 (B); also elsewhere on the board
GND: C2.2, C3.2, C51.2, C52.2, C53.2, C64.2, C65.2, C66.2, C67.2, C68.2, C69.2, C70.2, C71.2, C72.2, R25.2, R27.2, U3.2 (GND), U3.13 (PS/SYNC), U3.15 (PGND), U4.2 (GND), U4.13 (PS/SYNC), U4.15 (PGND); also elsewhere on the board
HPVCC: JP6.2 (B); also elsewhere on the board
unnamed: C68.1, C69.1, C70.1, C71.1, C72.1, JP5.1 (A), R24.1, TP21.1, U3.4 (VOUT), U3.5 (VOUT)
unnamed: C53.1, C64.1, C65.1, C66.1, C67.1, JP6.1 (A), R26.1, TP22.1, U4.4 (VOUT), U4.5 (VOUT)
unnamed: L1.1, U3.6 (L2), U3.7 (L2)
unnamed: L1.2, U3.8 (L1), U3.9 (L1)
unnamed: L2.1, U4.6 (L2), U4.7 (L2)
unnamed: L2.2, U4.8 (L1), U4.9 (L1)
unnamed: R24.2, R25.1, TP24.1, U3.3 (FB)
unnamed: R26.2, R27.1, TP23.1, U4.3 (FB)
PGOOD: U3.14 (PG), U4.14 (PG); also elsewhere on the board
PWREN: U3.12 (EN), U4.12 (EN); also elsewhere on the board
VBAT: C3.1, C51.1, U3.10 (VIN), U3.11 (VIN), U4.10 (VIN), U4.11 (VIN); also elsewhere on the board
VIPS: C2.1, C52.1, U3.1 (VINA), U4.1 (VINA); also elsewhere on the board

Notes on the sheet:
Using VBAT instead of VIPS Because VIPS is limited to 900mA
shoot for <1mOhm ESR on output cap
<57mOhm ESR
PG is open drain high-active power good Pulls reset low if power output unstable

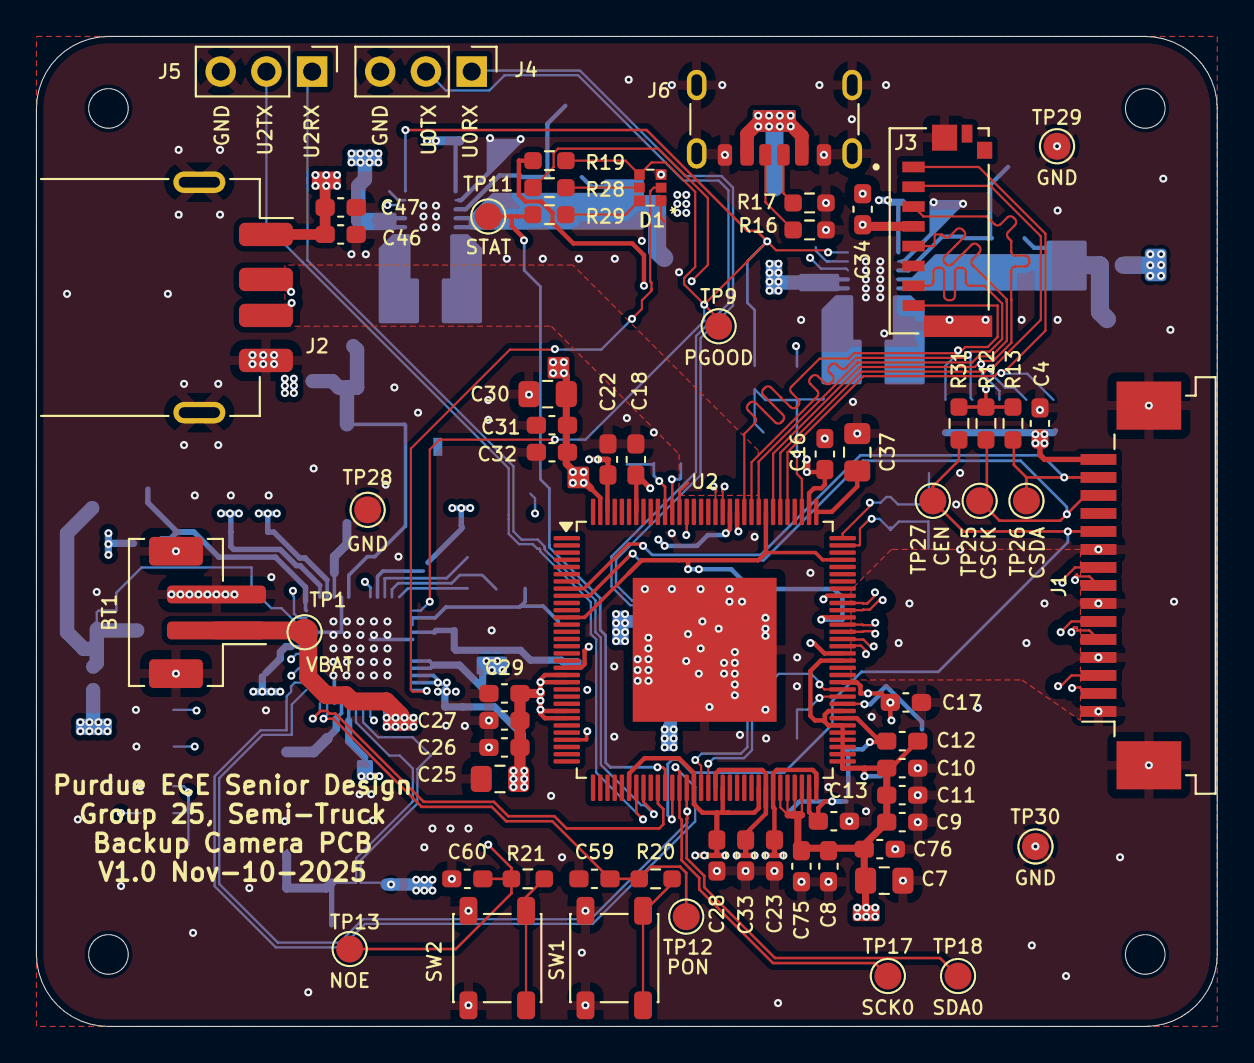
[picture p17: board CameraPCB.kicad_pcb from above]

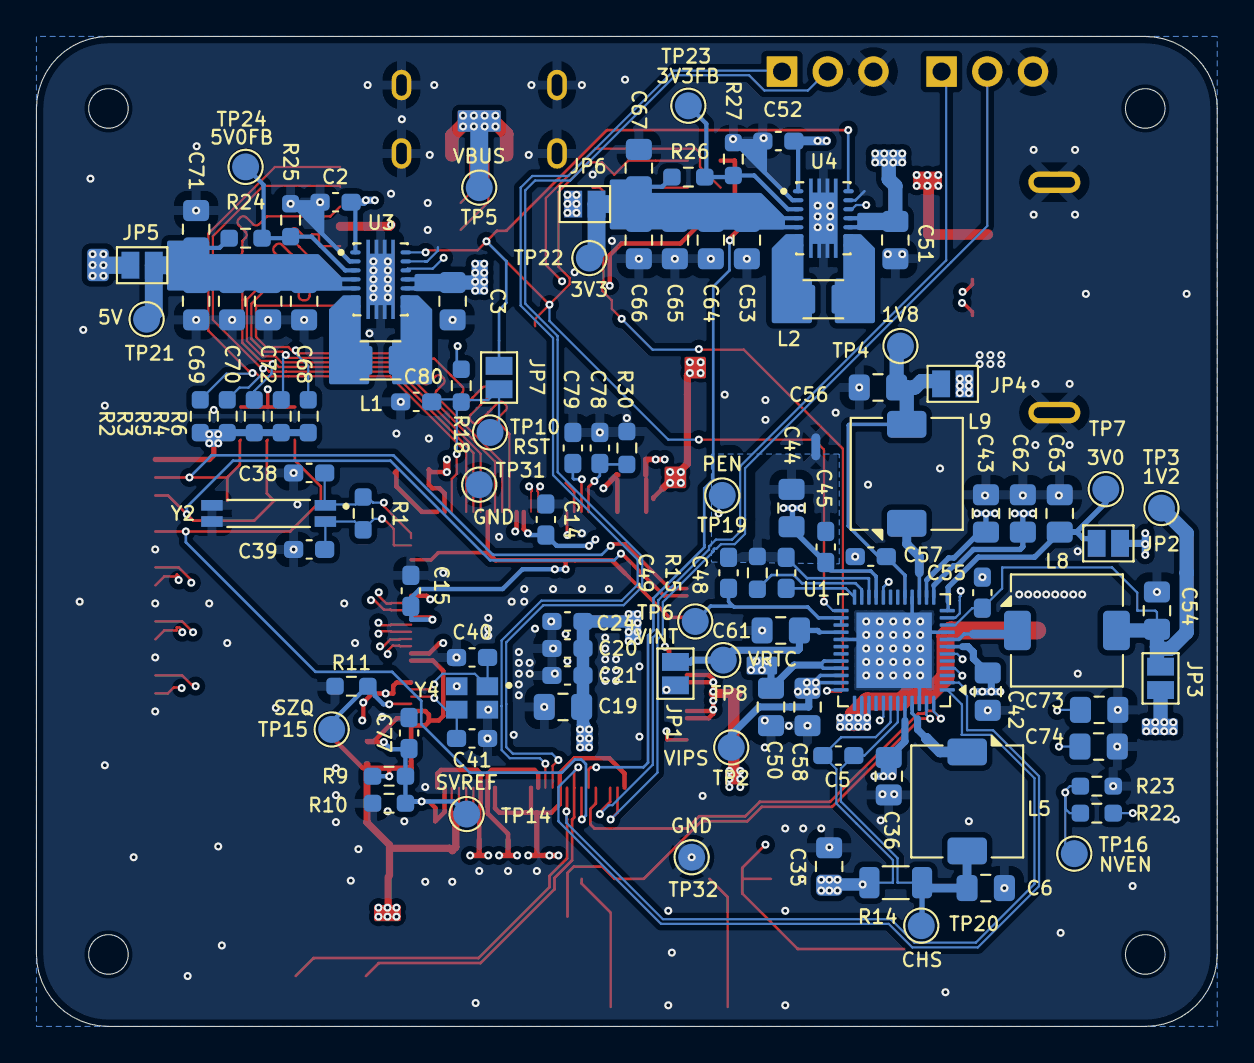
[picture p18: board CameraPCB.kicad_pcb from below]

Board: 6 copper layers, 65.6 x 55.0 mm, 173 parts (105 on the bottom side), 79 nets.
