JackkP/Semi-Truck-Backup-Camera/RPICAM_Adapter_PCB/KiCAD/RPICAM to LicheePiZero.kicad_pcb

## KiCad design RPICAM_Adapter_PCB/KiCAD/RPICAM to LicheePiZero.kicad_pcb (2025-10-03)

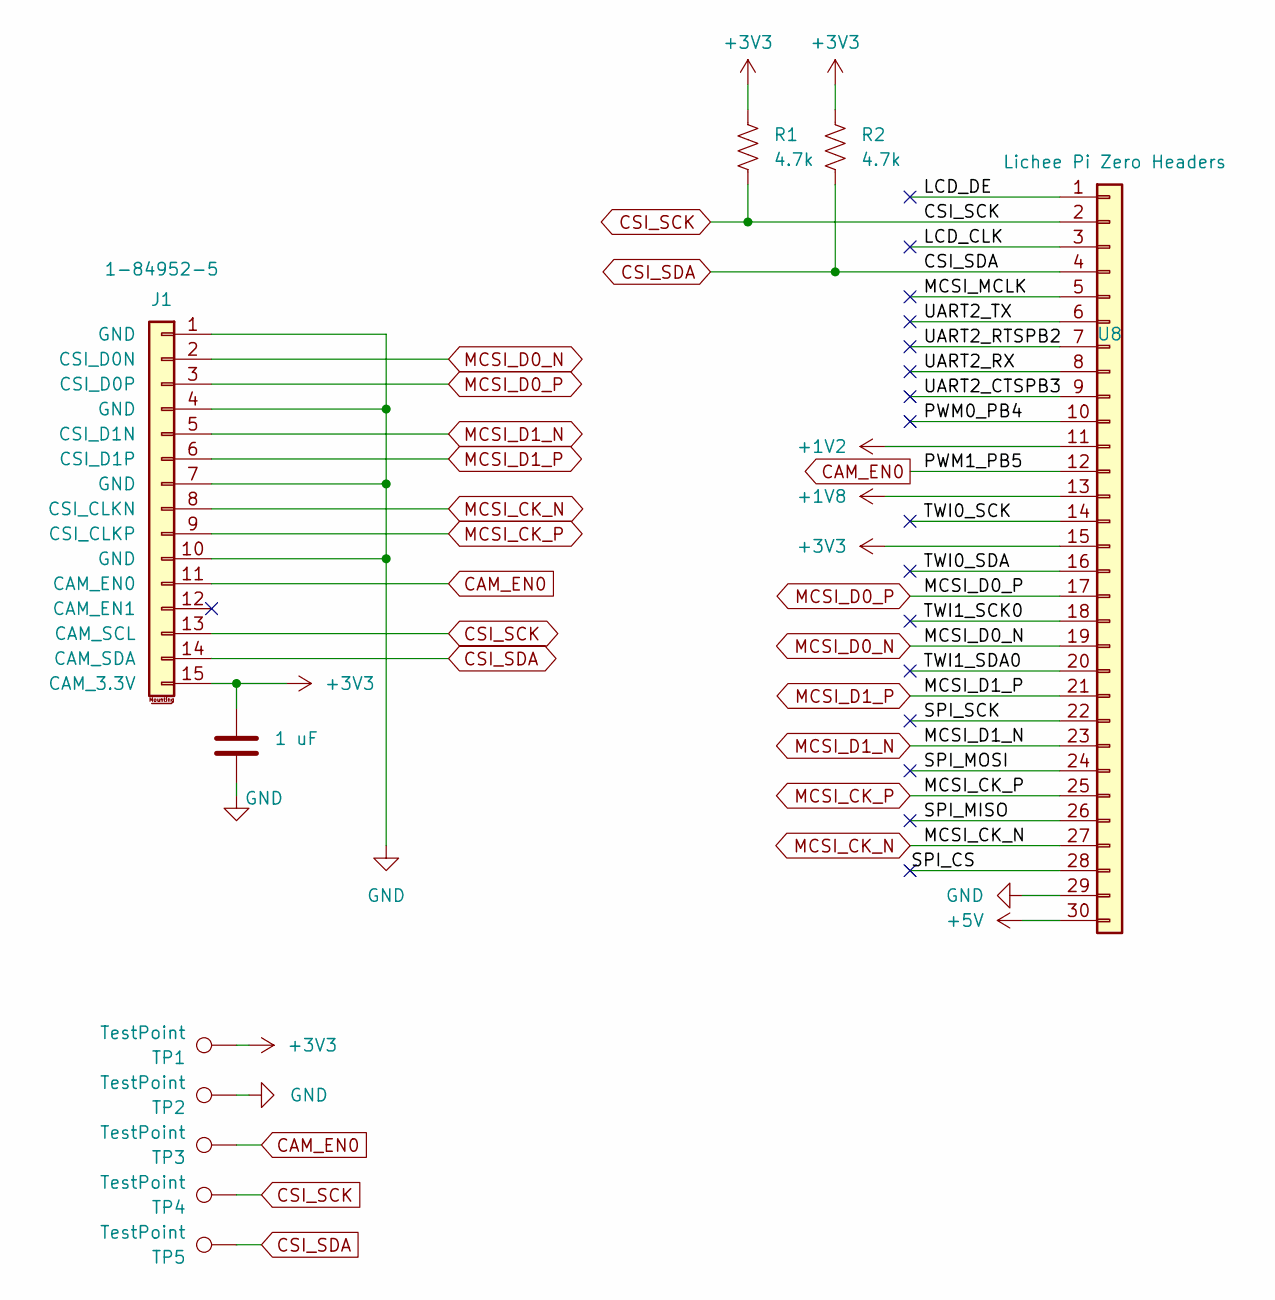
[picture p19: schematic RPICAM to LicheePiZero.kicad_sch]

Parts:
C1: 1 uF; C_0805_2012Metric_Pad1.18x1.45mm_HandSolder
J1: 1-84952-5; TE_1-84952-5_1x15-1MP_P1.0mm_Horizontal
R1, R2: 4.7k; R_0805_2012Metric_Pad1.20x1.40mm_HandSolder
TP1, TP2, TP3, TP4, TP5: TestPoint; TestPoint_Pad_D1.0mm
U8: Lichee Pi Zero Headers; PinHeader_1x30_P1.27mm_Vertical

Connections:
+1V2: U8.11
+1V8: U8.13
+3V3: C1.1, J1.15 (CAM_3.3V), R1.1, R2.1, TP1.1, U8.15
+5V: U8.30
/LCD_CLK: U8.3
/LCD_DE: U8.1
/MCSI_MCLK: U8.5
/PWM0_PB4: U8.10
/SPI_CS: U8.28
/SPI_MISO: U8.26
/SPI_MOSI: U8.24
/SPI_SCK: U8.22
/TWI0_SCK: U8.14
/TWI0_SDA: U8.16
/TWI1_SCK0: U8.18
/TWI1_SDA0: U8.20
/UART2_CTSPB3: U8.9
/UART2_RTSPB2: U8.7
/UART2_RX: U8.8
/UART2_TX: U8.6
CAM_EN0: J1.11 (CAM_EN0), TP3.1, U8.12
CSI_SCK: J1.13 (CAM_SCL), R1.2, TP4.1, U8.2
CSI_SDA: J1.14 (CAM_SDA), R2.2, TP5.1, U8.4
GND: C1.2, J1.1 (GND), J1.4 (GND), J1.7 (GND), J1.10 (GND), TP2.1, U8.29
MCSI_CK_N: J1.8 (CSI_CLKN), U8.27
MCSI_CK_P: J1.9 (CSI_CLKP), U8.25
MCSI_D0_N: J1.2 (CSI_D0N), U8.19
MCSI_D0_P: J1.3 (CSI_D0P), U8.17
MCSI_D1_N: J1.5 (CSI_D1N), U8.23
MCSI_D1_P: J1.6 (CSI_D1P), U8.21

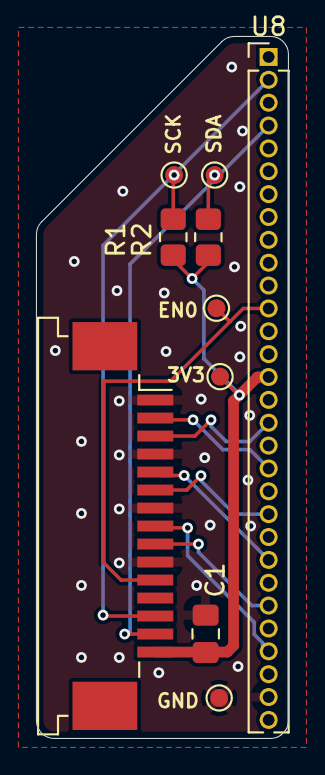
[picture p20: board RPICAM to LicheePiZero.kicad_pcb from above]

Board: 2 copper layers, 14.0 x 39.0 mm, 10 parts (0 on the bottom side), 11 nets.
