JackkP/Semi-Truck-Backup-Camera/(commit log)

2025-09-22 Created Camera PCB Project
    [Camera_PCB.kicad_pcb, Camera_PCB.kicad_sch]
2025-09-24 Init V3S chip added
    [Camera_PCB.kicad_sch]
2025-09-26 Modified symbol to inclued alternate pin descriptions
    [Camera_PCB.kicad_sch]
2025-09-26 Added Most Power Inputs
    [Camera_PCB.kicad_sch, Oscillators.kicad_sch, SD_Card.kicad_sch, Voltages.kicad_sch, codec.kicad_sch]
2025-09-26 Fixed Capacitor Naming
    [Oscillators.kicad_sch, SD_Card.kicad_sch, Voltages.kicad_sch, codec.kicad_sch]
2025-09-28 KiCAD Files for RPICAM to LicheePiZero Adapter PCB
    [RPICAM to LicheePiZero.kicad_pcb, RPICAM to LicheePiZero.kicad_sch]
2025-09-28 Some References for the Schematic
2025-09-30 Changed I2C interface for MIPI_CSI adapter board to use CSI TWI
    [RPICAM to LicheePiZero.kicad_sch]
2025-10-01 Schematic updates
    [Camera_PCB.kicad_sch, Oscillators.kicad_sch]
2025-10-03 This is the ordered version of the MIPI-CSI2 adapter PCB
    [RPICAM to LicheePiZero.kicad_pcb, RPICAM to LicheePiZero.kicad_sch]
2025-10-03 Camera connections added
    [Camera_PCB.kicad_sch, Voltages.kicad_sch, codec.kicad_sch]
2025-10-03 Pulled Adapter PCB files
2025-10-03 Readded Camera, USB connections
    [Camera_PCB.kicad_sch, camera.kicad_sch]
2025-10-04 Added x pins + text
    [Camera_PCB.kicad_sch]
2025-10-08 Changed usb -> A 2.0
    [Camera_PCB.kicad_sch, camera.kicad_sch]
2025-10-08 Switched pins 86, 87
    [Camera_PCB.kicad_sch, Oscillators.kicad_sch, SD_Card.kicad_sch, Voltages.kicad_sch, camera.kicad_sch]
2025-10-08 Create BatteryPower.kicad_sch-bak
2025-10-08 Initial Power Schem
    [BatteryPower.kicad_pcb, BatteryPower.kicad_sch]
2025-10-13 Started PCB
    [Camera_PCB-B_Cu.gbr, Camera_PCB-B_Mask.gbr, Camera_PCB-B_Paste.gbr, Camera_PCB-B_Silkscreen.gbr, Camera_PCB-Edge_Cuts.gbr, Camera_PCB-F_Cu.gbr, Camera_PCB-F_Mask.gbr, Camera_PCB-F_Paste.gbr]
2025-10-15 restructuring main branch to have power schematic in power directory
    [BatteryPower.kicad_pcb, BatteryPower.kicad_sch]
2025-10-21 adjustments to get wireless link setup complete and wireless streaming, had some problems getting video to stream since previous streaming commands were unencoding then re-encoding video stream. Vide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
2025-10-24 Commit Message
    [BatteryPower.kicad_sch]
2025-10-29 trying to clean up PCB branch
    [CameraPCB.kicad_pcb, CameraPCB.kicad_sch, Oscillators.kicad_sch, Power.kicad_sch, SD_Card.kicad_sch, V3s.kicad_sch, Voltages.kicad_sch, camera.kicad_sch]
2025-10-29 cleaned up PCB branch
    [CameraPCB - Copy.kicad_pcb, CameraPCB.kicad_pcb, CameraPCB.kicad_sch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]
2025-10-29 more PCB branch cleanup
    [CameraPCB - Copy.kicad_pcb]
2025-10-29 Updated Component Values for Power
    [Power.kicad_sch]
2025-10-29 10/29 Footprint Additions
    [CameraPCB.kicad_sch, Power.kicad_sch, V3s.kicad_sch, Voltages.kicad_sch, camera.kicad_sch]
2025-10-31 Camera PCB Schematic review 1
    [CameraPCB.kicad_sch, Power.kicad_sch, V3s.kicad_sch, Voltages.kicad_sch, camera.kicad_sch, untitled.kicad_sch]
2025-11-03 Schematic done, thoroughly reviewed by Jack, should get reviewed by Connor if possible.
    [CameraPCB.kicad_pcb, Voltages.kicad_sch, camera.kicad_sch, untitled.kicad_sch]
2025-11-03 cleaned up Camera_PCB \repository
    [3V3_5V0.kicad_sch, AXP203.kicad_sch, CSI_USB_SD_OSC.kicad_sch, CameraPCB.kicad_sch, DC_CAP_RAIL_TIES.kicad_sch, Oscillators.kicad_sch, Power.kicad_sch, SD_Card.kicad_sch]
2025-11-04 Thorough Camera PCB Review by Jack
    [3V3_5V0.kicad_sch, AXP203.kicad_sch, CSI_USB_SD_OSC.kicad_sch, CameraPCB.kicad_pcb, DC_CAP_RAIL_TIES.kicad_sch, V3s.kicad_sch]
2025-11-04 more schematic changes, added solder bridges, etc
    [3V3_5V0.kicad_sch, AXP203.kicad_sch, CameraPCB.kicad_pcb, DC_CAP_RAIL_TIES.kicad_sch, V3s.kicad_sch]
2025-11-05 PCB commit before reorganizing
    [3V3_5V0.kicad_sch, AXP203.kicad_sch, CSI_USB_SD_OSC.kicad_sch, CameraPCB.kicad_pcb, DC_CAP_RAIL_TIES.kicad_sch]
2025-11-05 Shrunk camera PCB and rearranged connectors. Everything on board. Not everything connected.
    [AXP203.kicad_sch, CameraPCB.kicad_pcb, DC_CAP_RAIL_TIES.kicad_sch]
2025-11-05 Only unconnected grounds in schematic. Still need to thoroughly clean up.
    [AXP203.kicad_sch, CameraPCB.kicad_pcb]
2025-11-06 replaced all power traces with zones
    [CameraPCB.kicad_pcb]
2025-11-07 PCB has no missing connections, (some missing grounds)
    [AXP203.kicad_sch, CameraPCB.kicad_pcb, V3s.kicad_sch]
2025-11-07 Pre sd-card move
    [10067099-200LF.STEP, CameraPCB.kicad_pcb]
2025-11-09 Added 3d models, completed layout. Should still review more.
    [AXP203.kicad_sch, B2B-PH-SM4-TB.step, CameraPCB.kicad_pcb, DFE201610E-1R0M=P2.STEP, ECS-.327-12.5-38-TR.STEP, ECS-240-12-36-AGN-TR.step, QFN48_P040_H085.stp, TPS63020DSJT.step]
2025-11-10 ordered PCB V1.0
    [CSI_USB_SD_OSC.kicad_sch, CameraPCB.kicad_pcb]
2025-11-10 generated gerbers for order
    [CameraPCB-B_Cu.gbl, CameraPCB-B_Mask.gbs, CameraPCB-B_Paste.gbp, CameraPCB-B_Silkscreen.gbo, CameraPCB-Edge_Cuts.gm1, CameraPCB-F_Cu.gtl, CameraPCB-F_Mask.gts, CameraPCB-F_Paste.gtp]
2025-11-11 resized vias to 0.2/0.45mm
    [CameraPCB.kicad_pcb]
2025-11-12 actual production gerbers after via resizing
    [CameraPCB-B_Cu.gbl, CameraPCB-B_Mask.gbs, CameraPCB-B_Paste.gbp, CameraPCB-B_Silkscreen.gbo, CameraPCB-Edge_Cuts.gm1, CameraPCB-F_Cu.gtl, CameraPCB-F_Mask.gts, CameraPCB-F_Paste.gtp]
